asilorgen/ME408_Inverted_Pendulum/README.md

Inverted Pendulum 

Sabanci University, Mechatronics System Design (ME 408) - Term Project

Final Report together with Arduino code uploaded
